ChristianY2001/VTOL-at-UNLV/mro_gps_mountback_heewing.stl

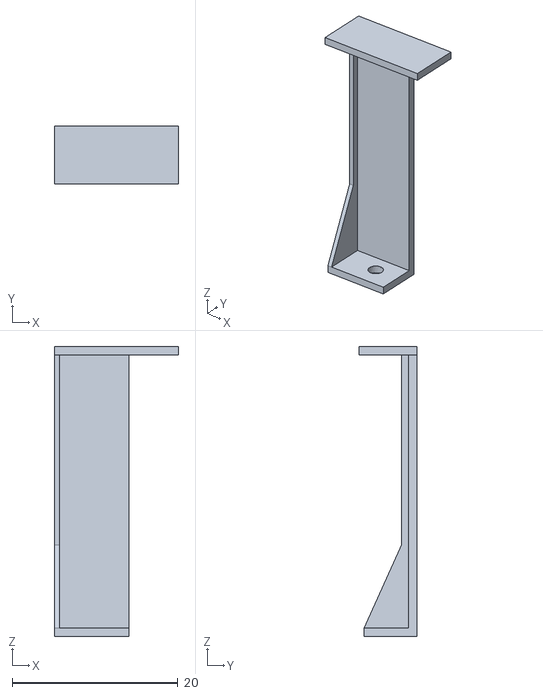
[picture p1: CAD file, 2023-03-05, last stored version]
mro_gps_mountback_heewing.stl
15.0 x 7.00 x 35.0
