ChristianY2001/VTOL-at-UNLV/gps_holder_heewing.stl

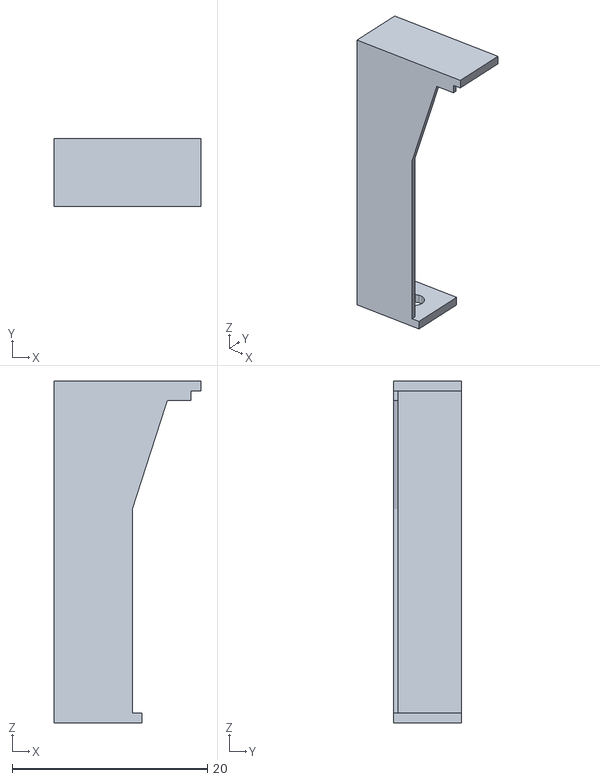
[picture p2: CAD file, 2023-03-05, last stored version]
gps_holder_heewing.stl
15.0 x 7.00 x 35.0
